MediaLabUniovi/Boya_Maritima/hardware/BoyaMontada.jpg

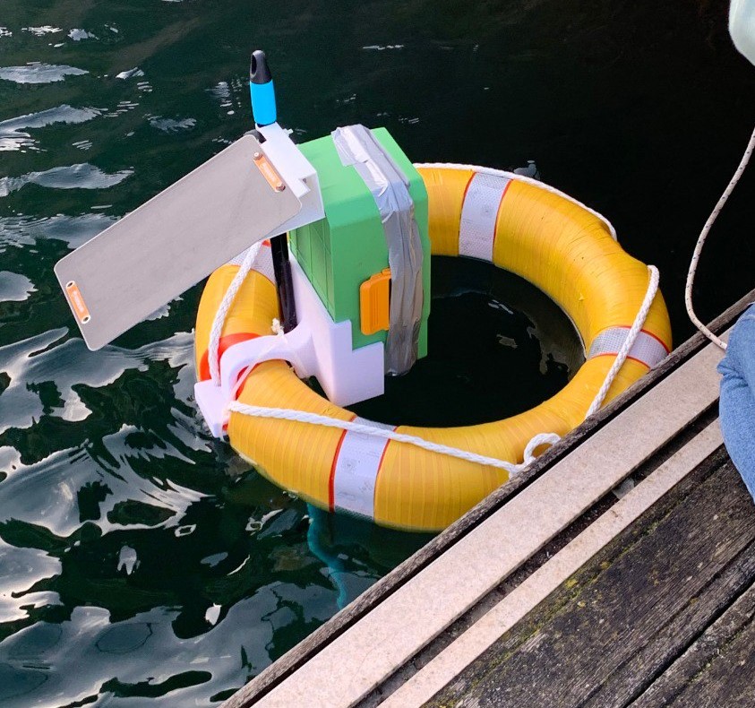
hardware/BoyaMontada.jpg
