MediaLabUniovi/Boya_Maritima/hardware/Schematic_Boya.png

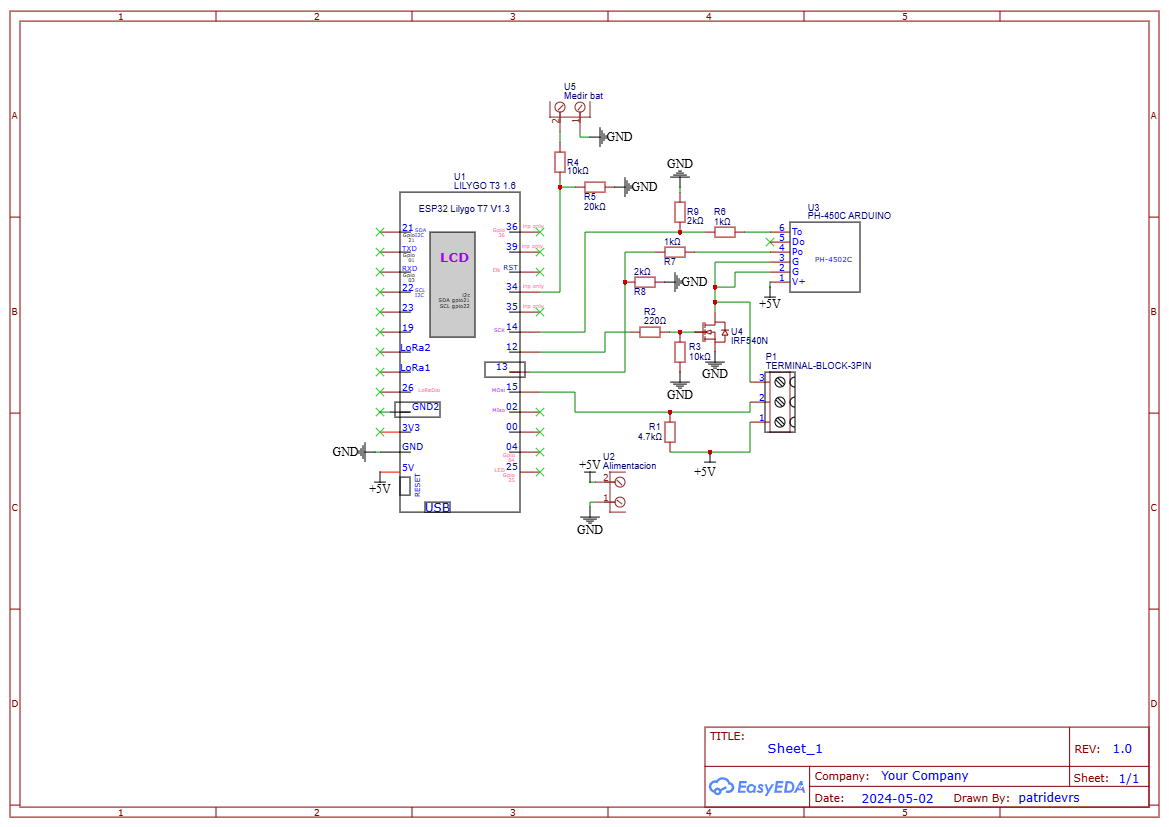
hardware/Schematic_Boya.png
