MediaLabUniovi/Boya_Maritima/(list of files, drawings)

Other design files:
hardware/PCB_boya.json
hardware/SCH_boya.json
