MediaLabUniovi/Boya_Maritima/(notices)

Notices in the files:
boya_LoRa/ttn.ino:
This program is free software: you can redistribute it and/or modify it under the terms of the GNU General Public License as published by the Free Software
